PUT-Motorsport/PUTM_EV_PDMv2_2024/hardware/hardware/FTSH-107-01-L-DV-K-A/FTSH-107-01-L-DV-K-A.stp

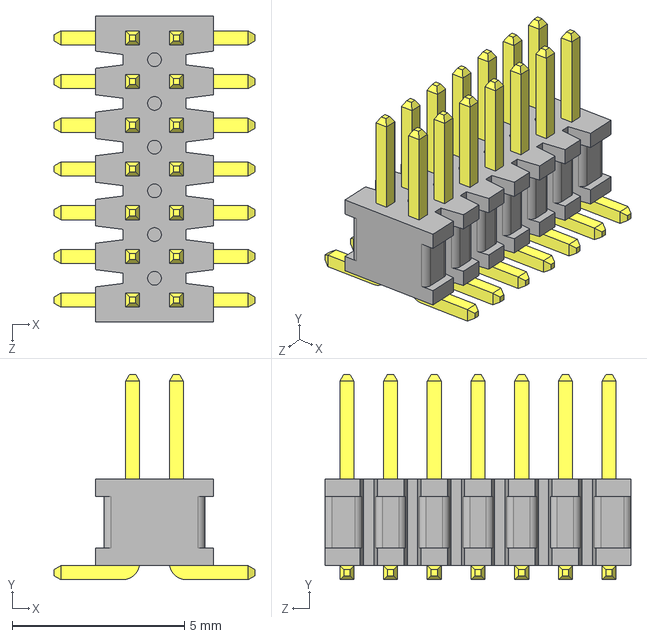
[picture p1: CAD file, 2024-11-11]
hardware/hardware/FTSH-107-01-L-DV-K-A/FTSH-107-01-L-DV-K-A.stp
5.84 x 5.97 x 8.89 mm
