PUT-Motorsport/PUTM_EV_PDMv2_2024/hardware/hardware/SKL34/SKL34.stp

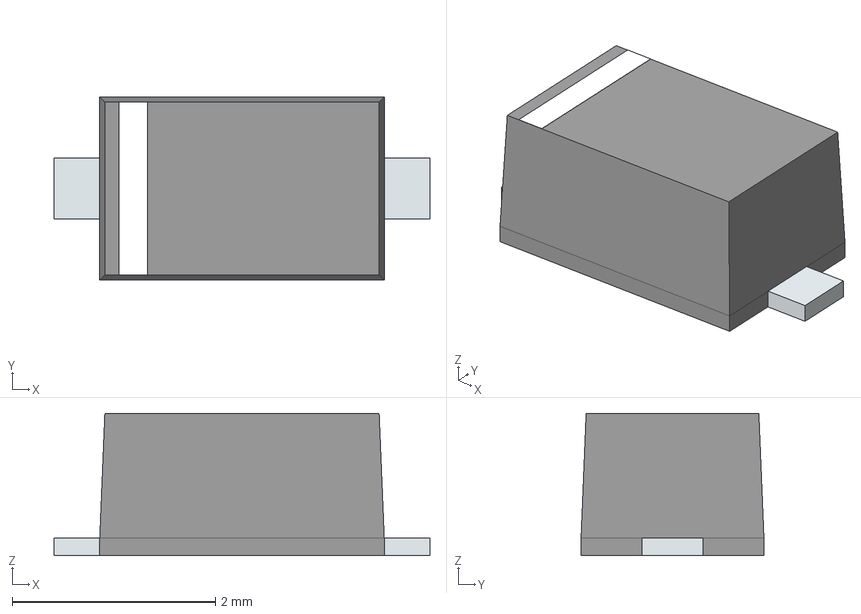
[picture p2: CAD file, 2024-12-08]
hardware/hardware/SKL34/SKL34.stp
3.70 x 1.80 x 1.40 mm
PinKIdent
PinK
PinA
