PUT-Motorsport/PUTM_EV_PDMv2_2024/hardware/hardware/UMPT-08-01-L-RA-WT-P-TR/UMPT-08-01-L-RA-WT-P-TR--3DModel-STEP-418109.STEP

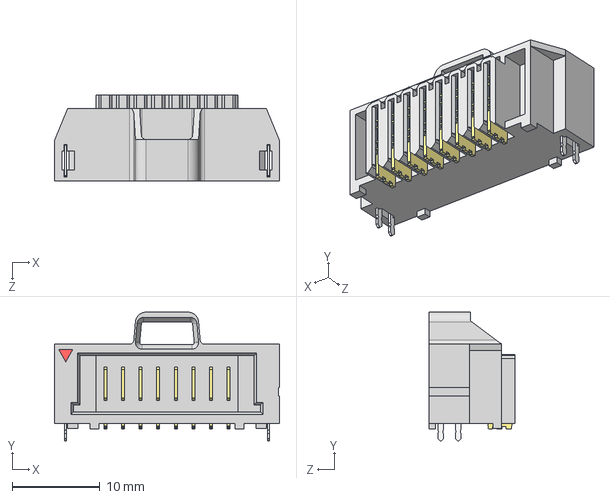
[picture p3: CAD file, 2024-12-08]
hardware/hardware/UMPT-08-01-L-RA-WT-P-TR/UMPT-08-01-L-RA-WT-P-TR--3DModel-STEP-418109.STEP
25.6 x 14.6 x 9.75 mm
