PUT-Motorsport/PUTM_EV_PDMv2_2024/hardware/hardware/UPT-02-01-01-L-RA/UPT-02-01-01-X-RA.step

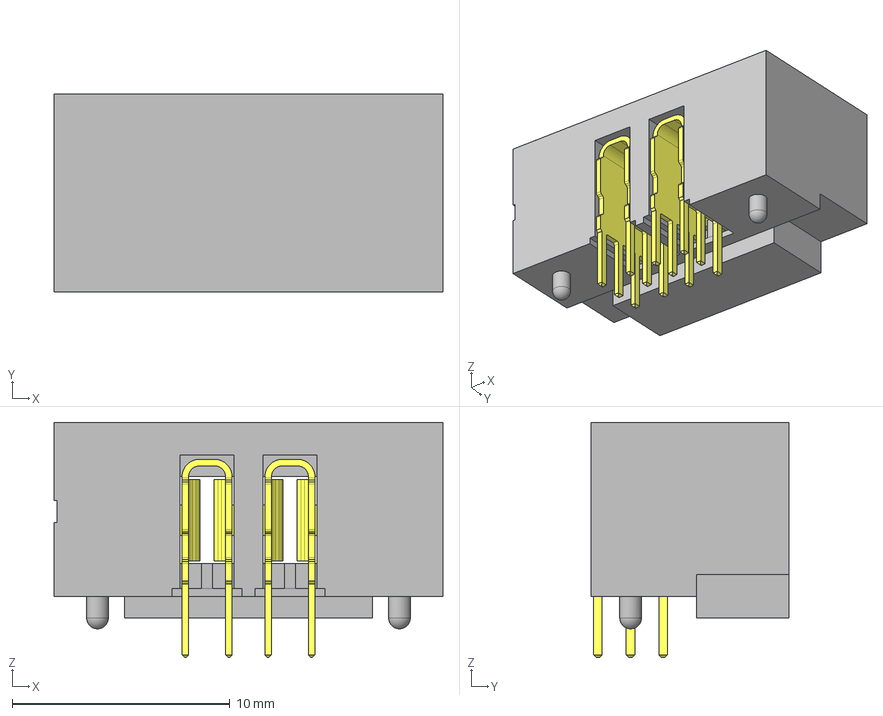
[picture p4: CAD file, 2024-11-05]
hardware/hardware/UPT-02-01-01-L-RA/UPT-02-01-01-X-RA.step
17.9 x 9.12 x 10.8 mm
UPT-03.0-0201-L-RAterminal
UPT-03.0-0201-L-RApins
