PUT-Motorsport/PUTM_EV_PDMv2_2024/hardware/hardware/UPT-08-01.0-01-L-RA/UPT-08-01-01-L-RA.stp

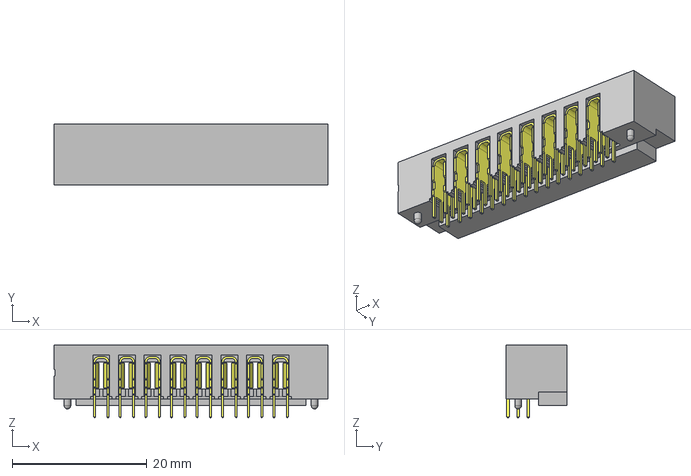
[picture p5: CAD file, 2024-11-05]
hardware/hardware/UPT-08-01.0-01-L-RA/UPT-08-01-01-L-RA.stp
40.7 x 9.12 x 10.8 mm
UPT-03.0-0801-L-RAterminal
UPT-03.0-0801-L-RApins
