PUT-Motorsport/PUTM_EV_PDMv2_2024/hardware/hardware/BTS722204ESAXUMA1/KiCad/BTS722204ESAXUMA1.stp

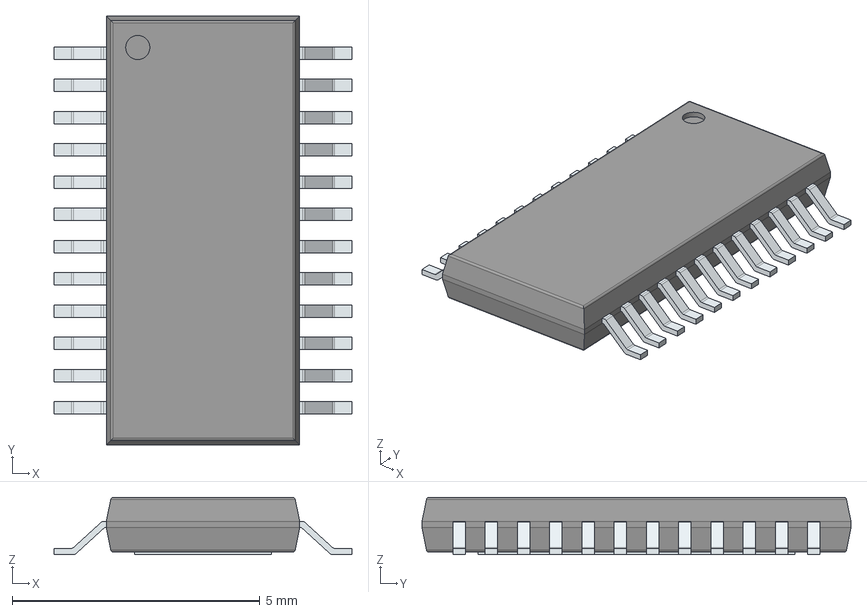
[picture p6: CAD file, 2024-11-11]
hardware/hardware/BTS722204ESAXUMA1/KiCad/BTS722204ESAXUMA1.stp
6.00 x 8.65 x 1.15 mm
PinsArrayLR
ThermalPad
