PUT-Motorsport/PUTM_EV_PDMv2_2024/hardware/hardware/inductor6_3/7447786147.stp

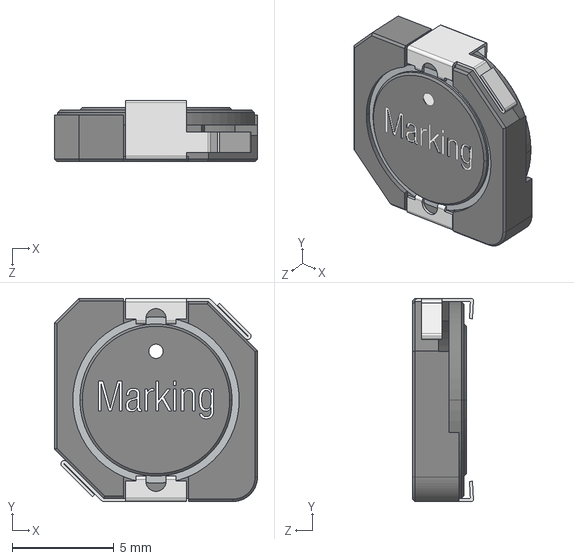
[picture p7: CAD file, 2024-11-11]
hardware/hardware/inductor6_3/7447786147.stp
10.0 x 10.0 x 3.00 mm
