PUT-Motorsport/PUTM_EV_PDMv2_2024/hardware/hardware/Redcube conn/74650073R.stp

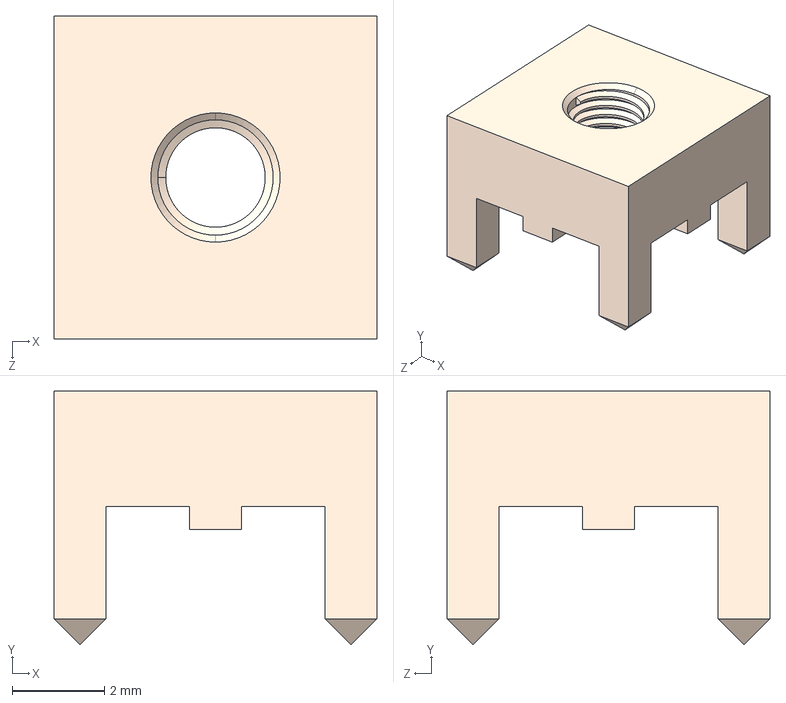
[picture p8: CAD file, 2024-12-08]
hardware/hardware/Redcube conn/74650073R.stp
7.00 x 5.50 x 7.00 mm
