PUT-Motorsport/PUTM_EV_PDMv2_2024/hardware/hardware/RedCube/7464100.stp

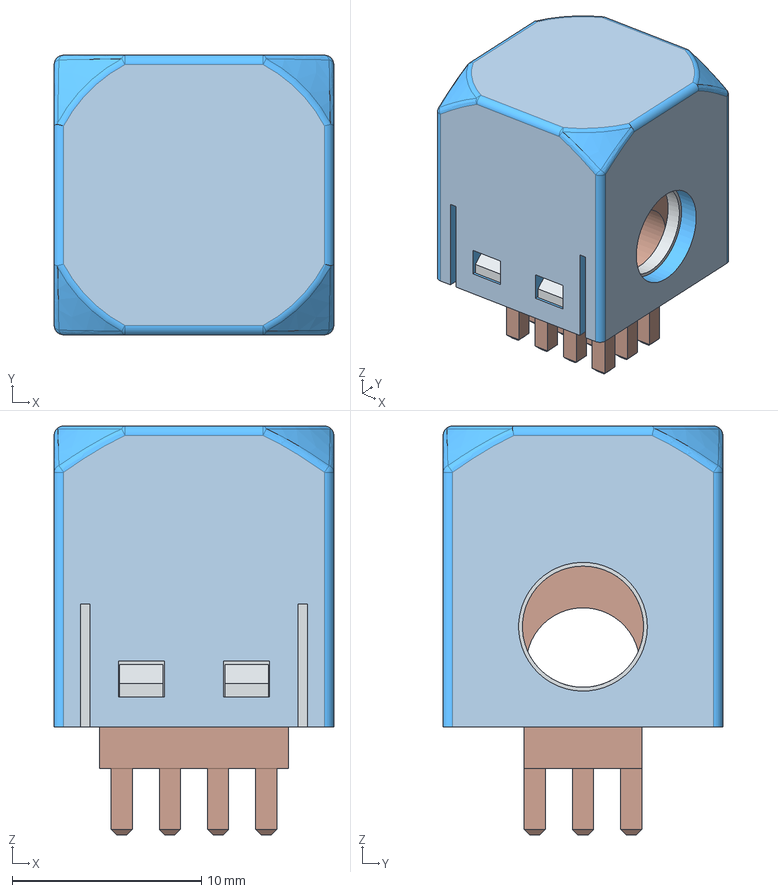
[picture p9: CAD file, 2024-12-08]
hardware/hardware/RedCube/7464100.stp
14.8 x 14.8 x 21.6 mm
Bottom Part
Top Part
pressure spring
