PUT-Motorsport/PUTM_EV_PDMv2_2024/hardware/PUTM_EV_PDMv2_2024.kicad_pcb

## KiCad design hardware/PUTM_EV_PDMv2_2024.kicad_pcb (2025-03-18)

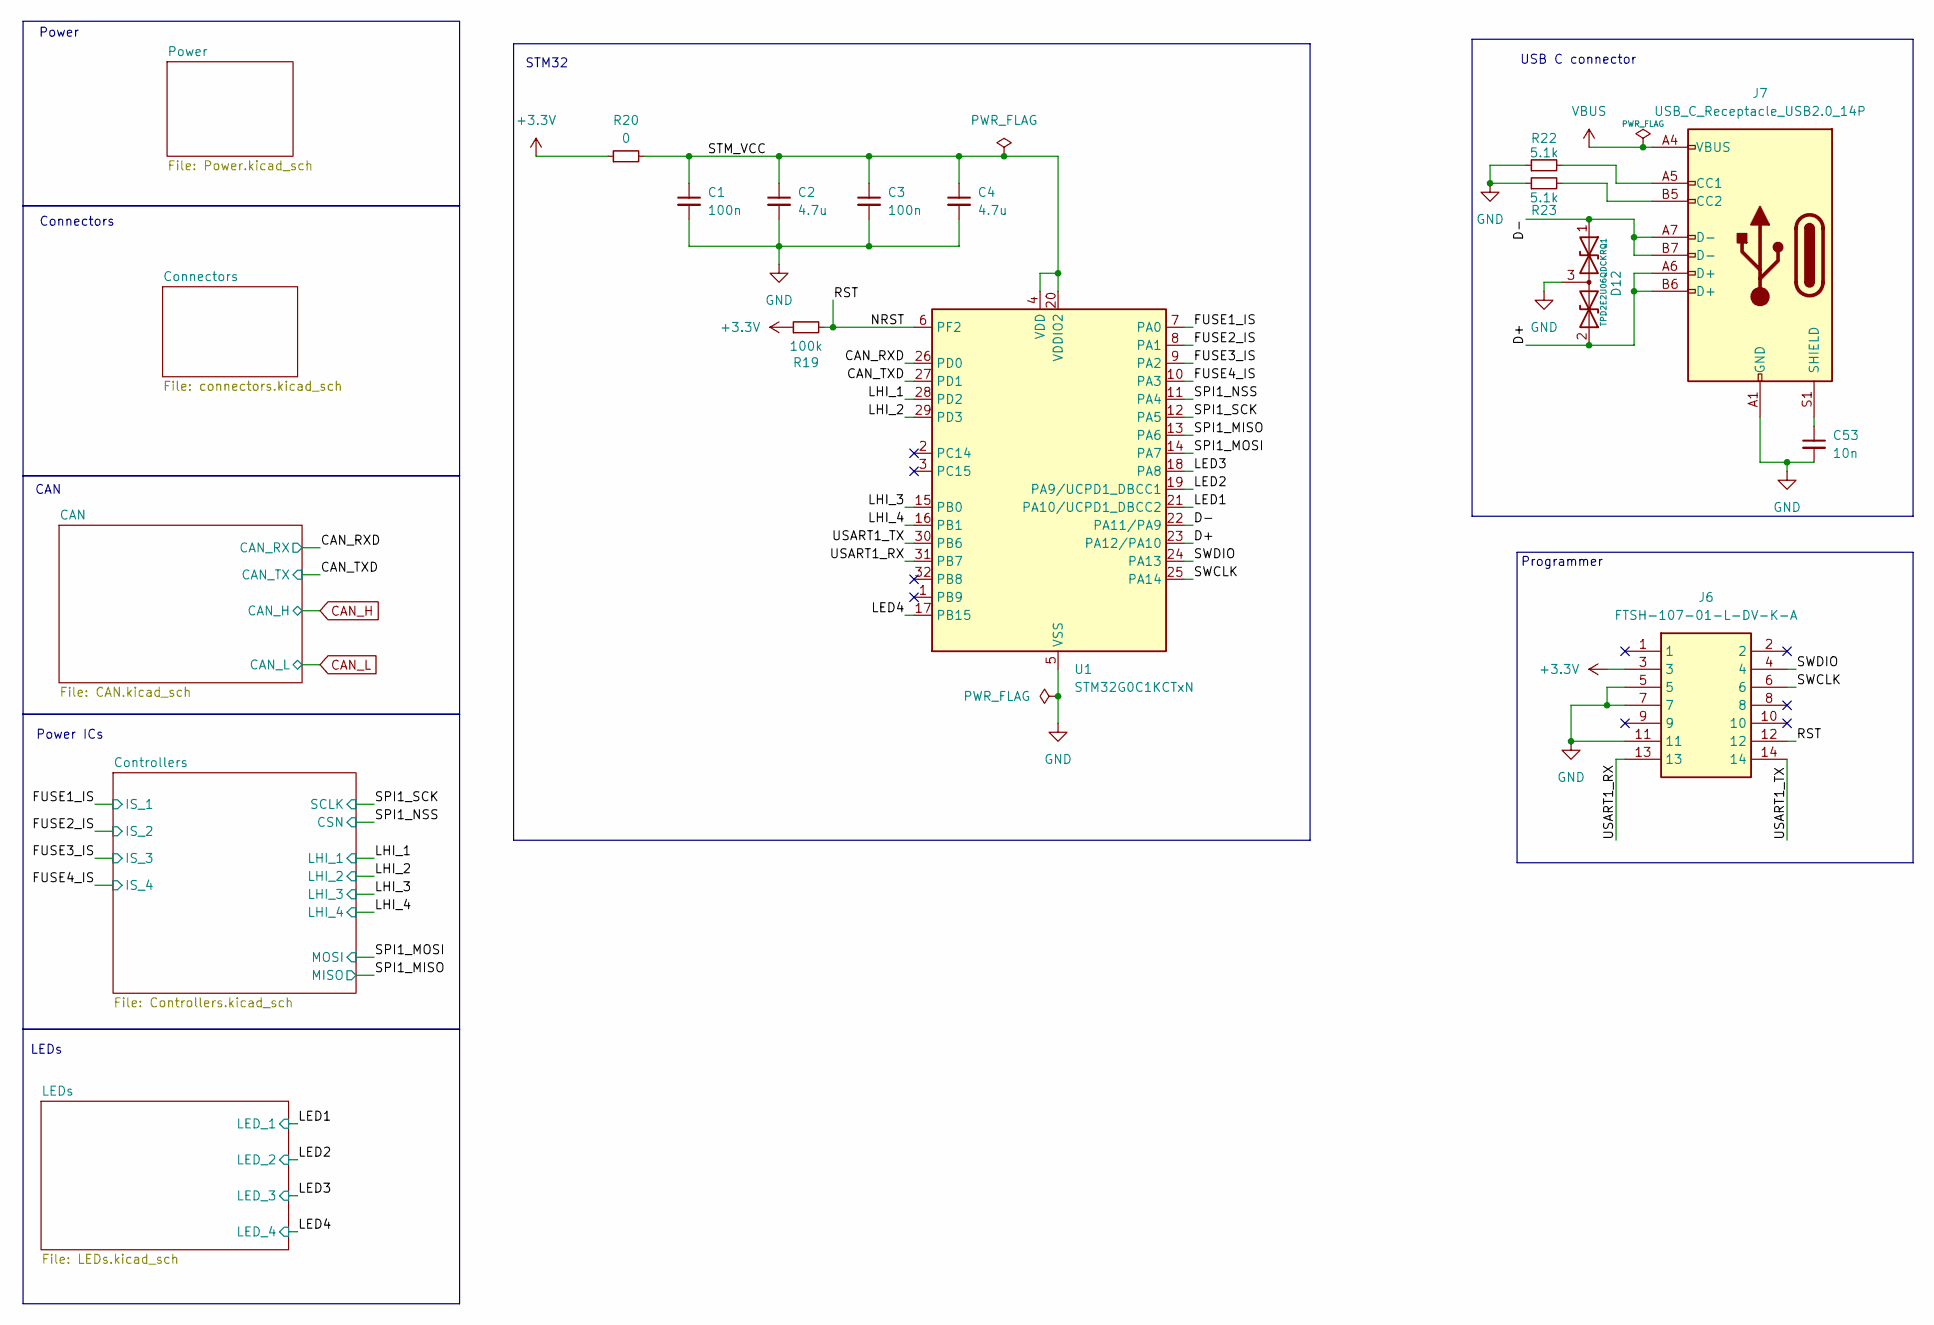
[picture p10: schematic PUTM_EV_PDMv2_2024.kicad_sch]

Parts:
C1, C3: 100n; C_0603_1608Metric
C2, C4: 4.7u; C_0603_1608Metric
C53: 10n; C_0603_1608Metric_Pad1.08x0.95mm_HandSolder
D12: TPD2E2U06QDCKRQ1; SOT-323_SC-70_Handsoldering
J6: FTSH-107-01-L-DV-K-A; FTSH-107-XX-YYY-DV-K-A; Mouser Part Number 200-FTSH10701LDVKA
J7: USB_C_Receptacle_USB2.0_14P; USB_C_Receptacle_JAE_DX07S024WJ3R400
R19: 100k; R_0603_1608Metric
R20: 0; R_0603_1608Metric_Pad0.98x0.95mm_HandSolder
R22, R23: 5.1k; R_0603_1608Metric_Pad0.98x0.95mm_HandSolder
U1: STM32G0C1KCTxN; LQFP-32_7x7mm_P0.8mm

Connections:
+3.3V: J6.3, R19.1, R20.1; also elsewhere on the board
/CAN_RXD: U1.26 (PD0); also elsewhere on the board
/CAN_TXD: U1.27 (PD1); also elsewhere on the board
/D+: D12.2 (A2), J7.A6 (D+), J7.B6 (D+), U1.23 (PA12/PA10)
/D-: D12.1 (A1), J7.A7 (D-), J7.B7 (D-), U1.22 (PA11/PA9)
/FUSE1_IS: U1.7 (PA0); also elsewhere on the board
/FUSE2_IS: U1.8 (PA1); also elsewhere on the board
/FUSE3_IS: U1.9 (PA2); also elsewhere on the board
/FUSE4_IS: U1.10 (PA3); also elsewhere on the board
/LED1: U1.21 (PA10/UCPD1_DBCC2); also elsewhere on the board
/LED2: U1.19 (PA9/UCPD1_DBCC1); also elsewhere on the board
/LED3: U1.18 (PA8); also elsewhere on the board
/LED4: U1.17 (PB15); also elsewhere on the board
/LHI_1: U1.28 (PD2); also elsewhere on the board
/LHI_2: U1.29 (PD3); also elsewhere on the board
/LHI_3: U1.15 (PB0); also elsewhere on the board
/LHI_4: U1.16 (PB1); also elsewhere on the board
/NRST: J6.12, R19.2, U1.6 (PF2)
/SPI1_MISO: U1.13 (PA6); also elsewhere on the board
/SPI1_MOSI: U1.14 (PA7); also elsewhere on the board
/SPI1_NSS: U1.11 (PA4); also elsewhere on the board
/SPI1_SCK: U1.12 (PA5); also elsewhere on the board
/STM_VCC: C1.1, C2.1, C3.1, C4.1, R20.2, U1.4 (VDD), U1.20 (VDDIO2)
/SWCLK: J6.6, U1.25 (PA14)
/SWDIO: J6.4, U1.24 (PA13)
/USART1_RX: J6.13, U1.31 (PB7)
/USART1_TX: J6.14, U1.30 (PB6)
GND: C1.2, C2.2, C3.2, C4.2, C53.2, D12.3 (common), J6.5, J6.7, J6.11, J7.A1 (GND), J7.A12 (GND), J7.B1 (GND), J7.B12 (GND), R22.1, R23.1, U1.5 (VSS); also elsewhere on the board
unnamed: J7.A5 (CC1), R22.2
unnamed: J7.B5 (CC2), R23.2
unnamed: C53.1, J7.S1 (SHIELD)
VBUS: J7.A4 (VBUS), J7.A9 (VBUS), J7.B4 (VBUS), J7.B9 (VBUS); also elsewhere on the board

Notes on the sheet:
Connectors
CAN
Programmer
LEDs
STM32
USB C connector
Power
Power ICs

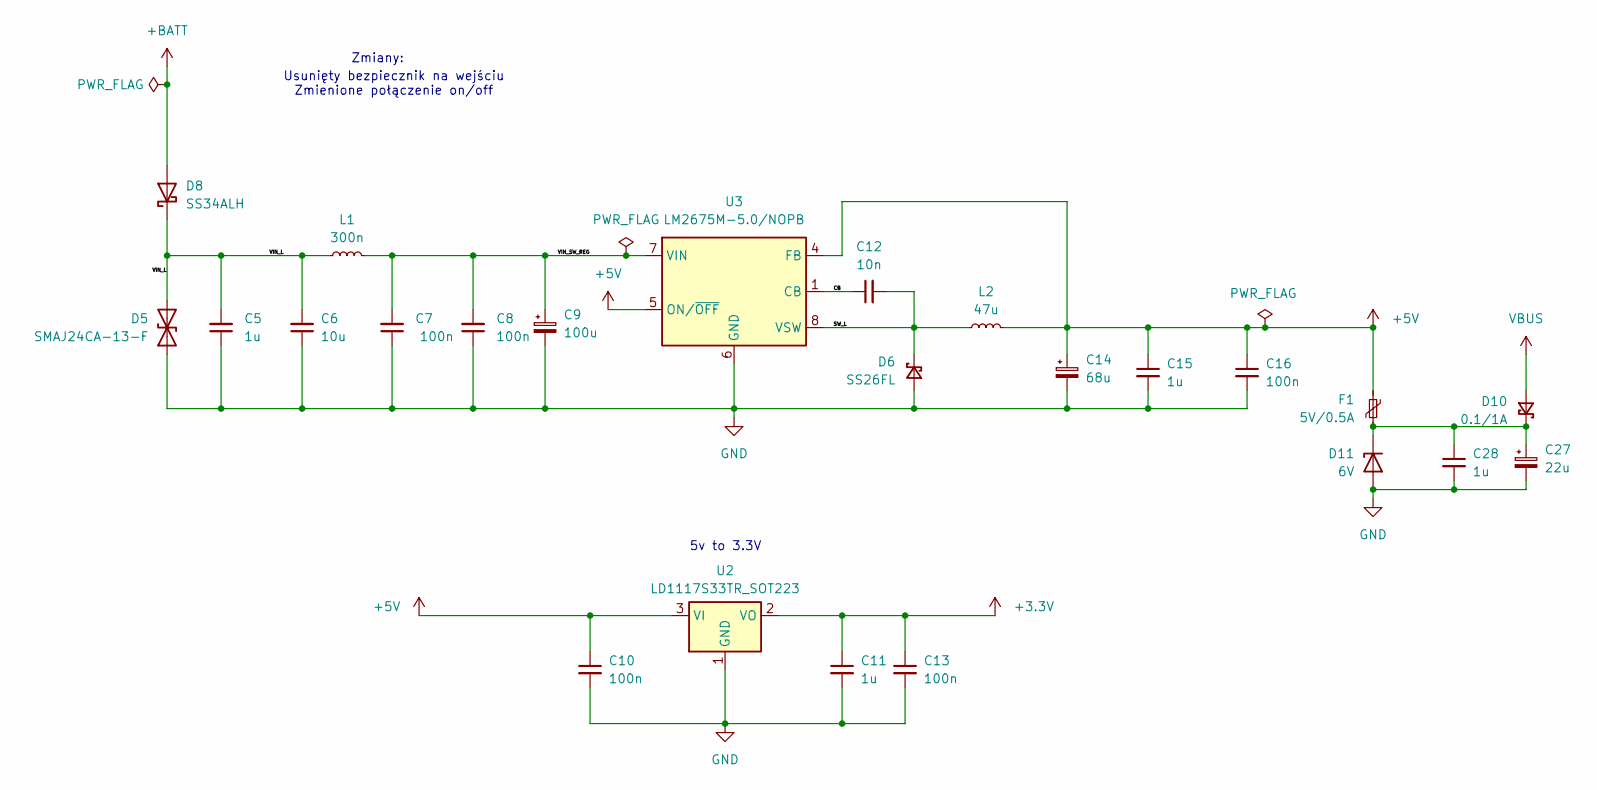
[picture p11: schematic Power.kicad_sch]

Parts:
C5, C11, C15: 1u; C_0603_1608Metric
C6: 10u; C_0603_1608Metric
C7, C8, C10, C13, C16: 100n; C_0603_1608Metric
C9: 100u; CP_Elec_6.3x7.7
C12: 10n; C_0603_1608Metric
C14: 68u; CP_Elec_6.3x5.4
C27: 22u; CP_Elec_4x4.5
C28: 1u; C_0603_1608Metric_Pad1.08x0.95mm_HandSolder
D5: SMAJ24CA-13-F; D_SMA; Mouser Part Number 621-SMAJ24CA-13-F
D6: SS26FL; D_SOD-123
D8: SS34ALH; D_SMA
D10: 0.1/1A; D_SMA
D11: 6V; D_SOD-123
F1: 5V/0.5A; Fuse_1206_3216Metric_Pad1.42x1.75mm_HandSolder
L1: 300n; L_0603_1608Metric
L2: 47u; L_6.3x6.3_H3
U2: LD1117S33TR_SOT223; SOT-223-3_TabPin2
U3: LM2675M-5.0/NOPB; SOIC-8_3.9x4.9mm_P1.27mm

Connections:
+3.3V: C11.1, C13.1, U2.2 (VO); also elsewhere on the board
+5V: C10.1, C14.1, C15.1, C16.1, F1.1, L2.2, U2.3 (VI), U3.4 (FB), U3.5 (ON/~OFF); also elsewhere on the board
+BATT: D8.2 (A); also elsewhere on the board
/Power/CB: C12.1, U3.1 (CB)
/Power/SW_L: C12.2, D6.1 (K), L2.1, U3.8 (VSW)
/Power/VIN_L: C5.2, C6.2, D5.2 (A2), D8.1 (K), L1.1
/Power/VIN_SW_REG: C7.2, C8.2, C9.1, L1.2, U3.7 (VIN)
GND: C5.1, C6.1, C7.1, C8.1, C9.2, C10.2, C11.2, C13.2, C14.2, C15.2, C16.2, C27.2, C28.2, D5.1 (A1), D6.2 (A), D11.2 (A), U2.1 (GND), U3.6 (GND); also elsewhere on the board
unnamed: C27.1, C28.1, D10.1 (K), D11.1 (K), F1.2
VBUS: D10.2 (A); also elsewhere on the board

Notes on the sheet:
Zmiany:
Usunięty bezpiecznik na wejściu Zmienione połączenie on/off
5v to 3.3V

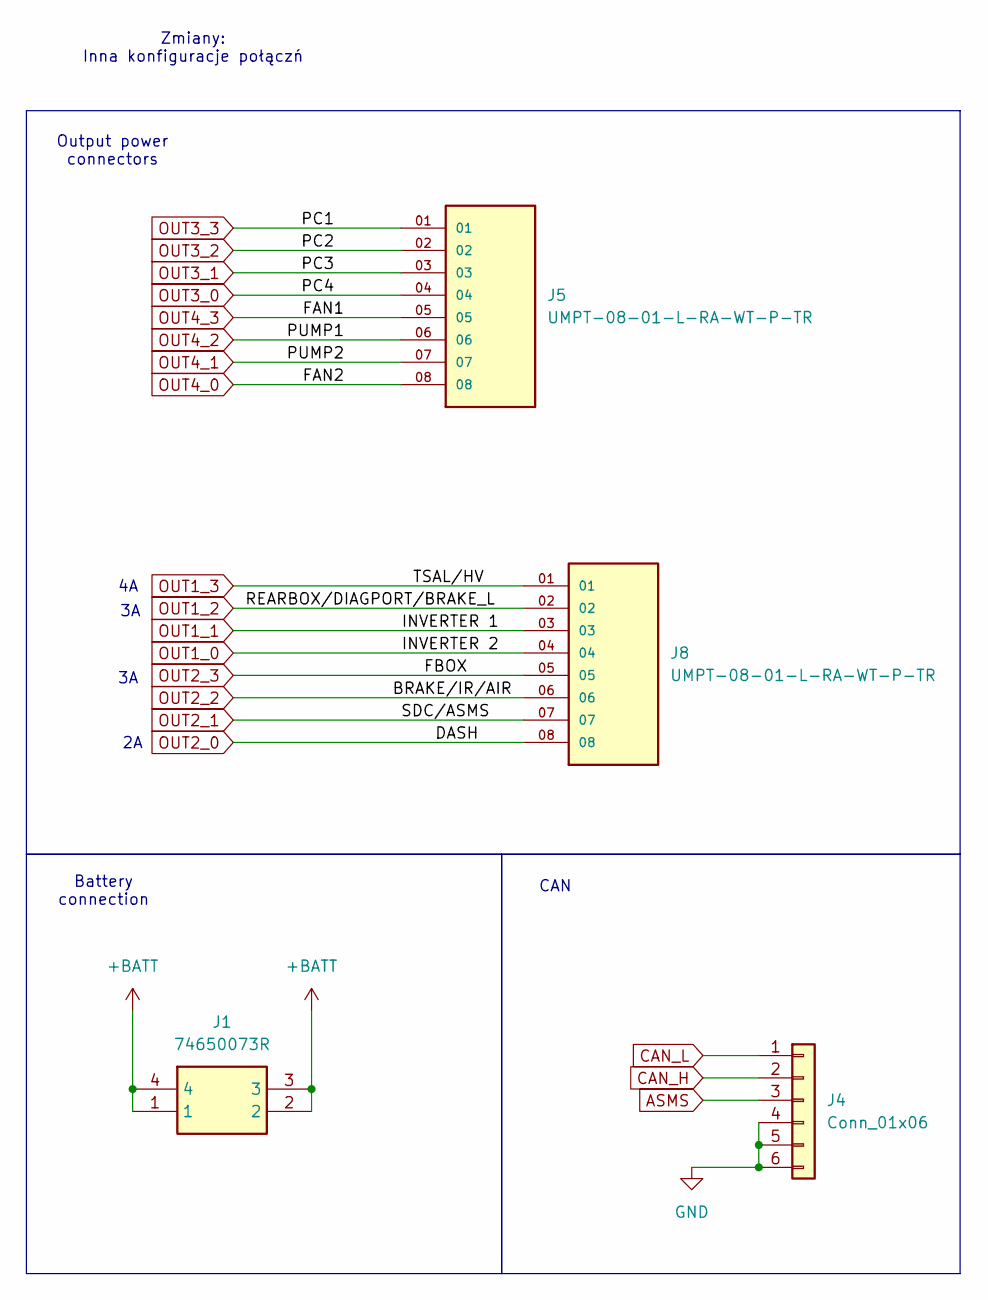
[picture p12: schematic connectors.kicad_sch]

Parts:
J1: 74650073R; Mouser Part Number 710-74650073R
J4: Conn_01x06; IDC-Header_2x03_P2.54mm_Vertical
J5, J8: UMPT-08-01-L-RA-WT-P-TR; SAMTEC_UMPT-08-01-L-RA-WT-P-TR

Connections:
+BATT: J1.1, J1.2, J1.3, J1.4; also elsewhere on the board
ASMS: J4.3
CAN_H: J4.2; also elsewhere on the board
CAN_L: J4.1; also elsewhere on the board
GND: J4.4, J4.5, J4.6; also elsewhere on the board
OUT1_0: J8.04; also elsewhere on the board
OUT1_1: J8.03; also elsewhere on the board
OUT1_2: J8.02; also elsewhere on the board
OUT1_3: J8.01; also elsewhere on the board
OUT2_0: J8.08; also elsewhere on the board
OUT2_1: J8.07; also elsewhere on the board
OUT2_2: J8.06; also elsewhere on the board
OUT2_3: J8.05; also elsewhere on the board
OUT3_0: J5.04; also elsewhere on the board
OUT3_1: J5.03; also elsewhere on the board
OUT3_2: J5.02; also elsewhere on the board
OUT3_3: J5.01; also elsewhere on the board
OUT4_0: J5.08; also elsewhere on the board
OUT4_1: J5.07; also elsewhere on the board
OUT4_2: J5.06; also elsewhere on the board
OUT4_3: J5.05; also elsewhere on the board

Notes on the sheet:
CAN
Battery connection
Output power connectors
Zmiany: Inna konfiguracje połączń

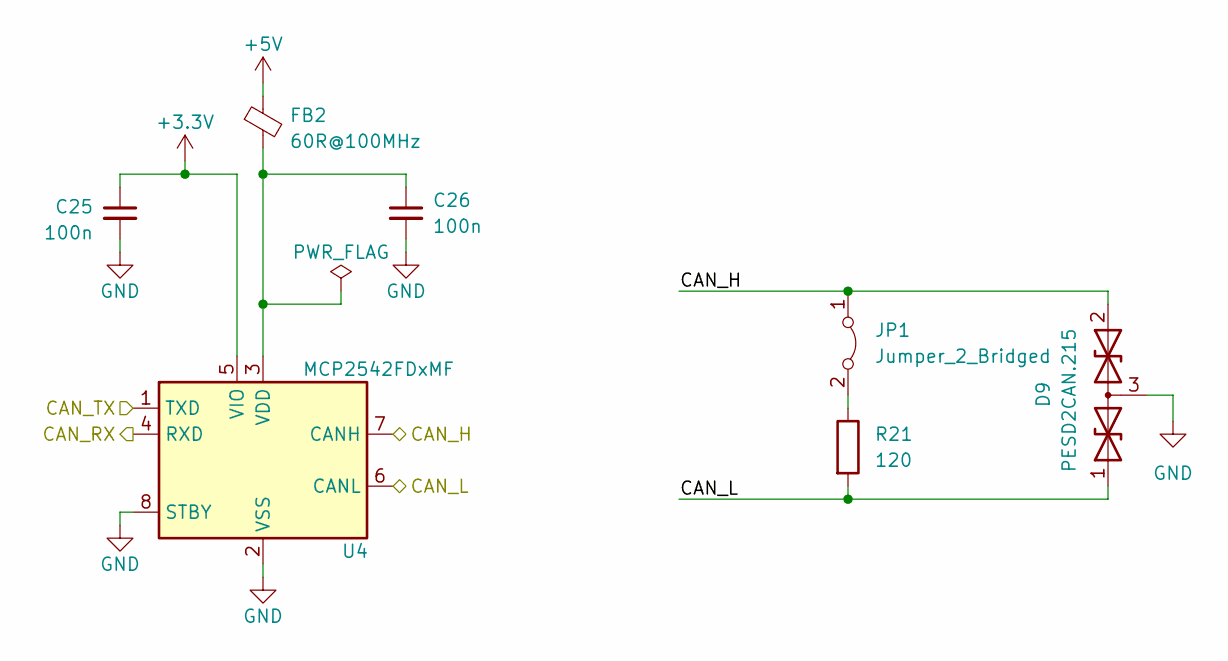
[picture p13: schematic CAN.kicad_sch]

Parts:
C25, C26: 100n; C_0603_1608Metric_Pad1.08x0.95mm_HandSolder
D9: PESD2CAN.215; SOT-23
FB2: 60R@100MHz; L_0603_1608Metric
JP1: Jumper_2_Bridged; PinHeader_1x02_P2.54mm_Vertical
R21: 120; R_0603_1608Metric_Pad0.98x0.95mm_HandSolder
U4: MCP2542FDxMF; DFN-8-1EP_3x3mm_P0.65mm_EP1.55x2.4mm

Connections:
+3.3V: C25.1, U4.5 (VIO); also elsewhere on the board
+5V: FB2.1; also elsewhere on the board
/CAN_RXD: U4.4 (RXD); also elsewhere on the board
/CAN_TXD: U4.1 (TXD); also elsewhere on the board
CAN_H: D9.2 (A2), JP1.1 (A), U4.7 (CANH); also elsewhere on the board
CAN_L: D9.1 (A1), R21.2, U4.6 (CANL); also elsewhere on the board
GND: C25.2, C26.2, D9.3 (common), U4.2 (VSS), U4.8 (STBY), U4.9 (VSS); also elsewhere on the board
unnamed: JP1.2 (B), R21.1
unnamed: C26.1, FB2.2, U4.3 (VDD)

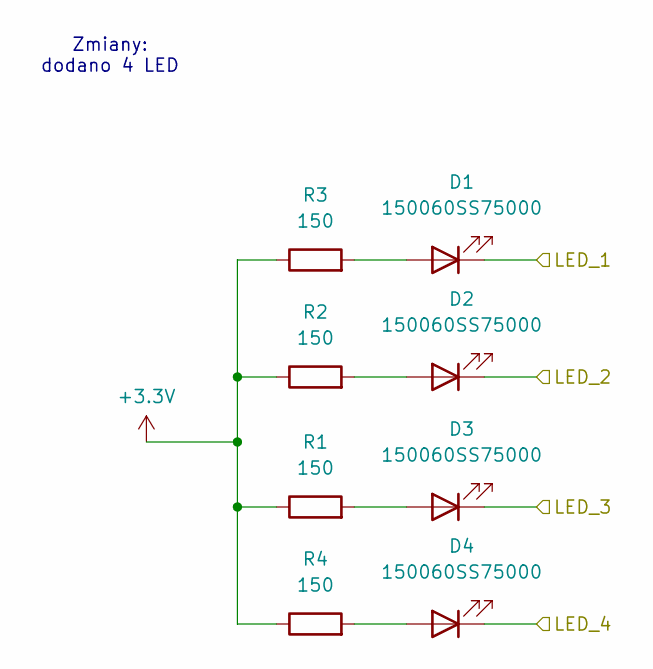
[picture p14: schematic LEDs.kicad_sch]

Parts:
D1, D2, D3, D4: 150060SS75000; LED_0603_1608Metric
R1, R2, R3, R4: 150; R_0603_1608Metric_Pad0.98x0.95mm_HandSolder

Connections:
+3.3V: R1.1, R2.1, R3.1, R4.1; also elsewhere on the board
/LED1: D1.1 (K); also elsewhere on the board
/LED2: D2.1 (K); also elsewhere on the board
/LED3: D3.1 (K); also elsewhere on the board
/LED4: D4.1 (K); also elsewhere on the board
unnamed: D1.2 (A), R3.2
unnamed: D2.2 (A), R2.2
unnamed: D3.2 (A), R1.2
unnamed: D4.2 (A), R4.2

Notes on the sheet:
Zmiany: dodano 4 LED

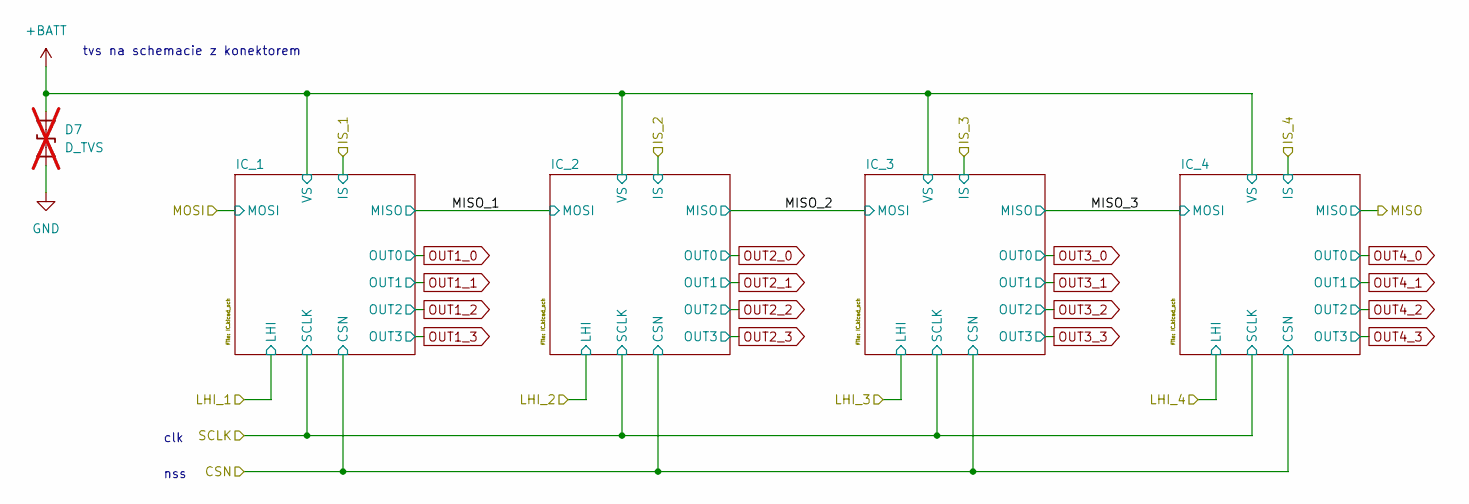
[picture p15: schematic Controllers.kicad_sch]

Parts:
D7: D_TVS; not fitted

Notes on the sheet:
nss
clk
tvs na schemacie z konektorem

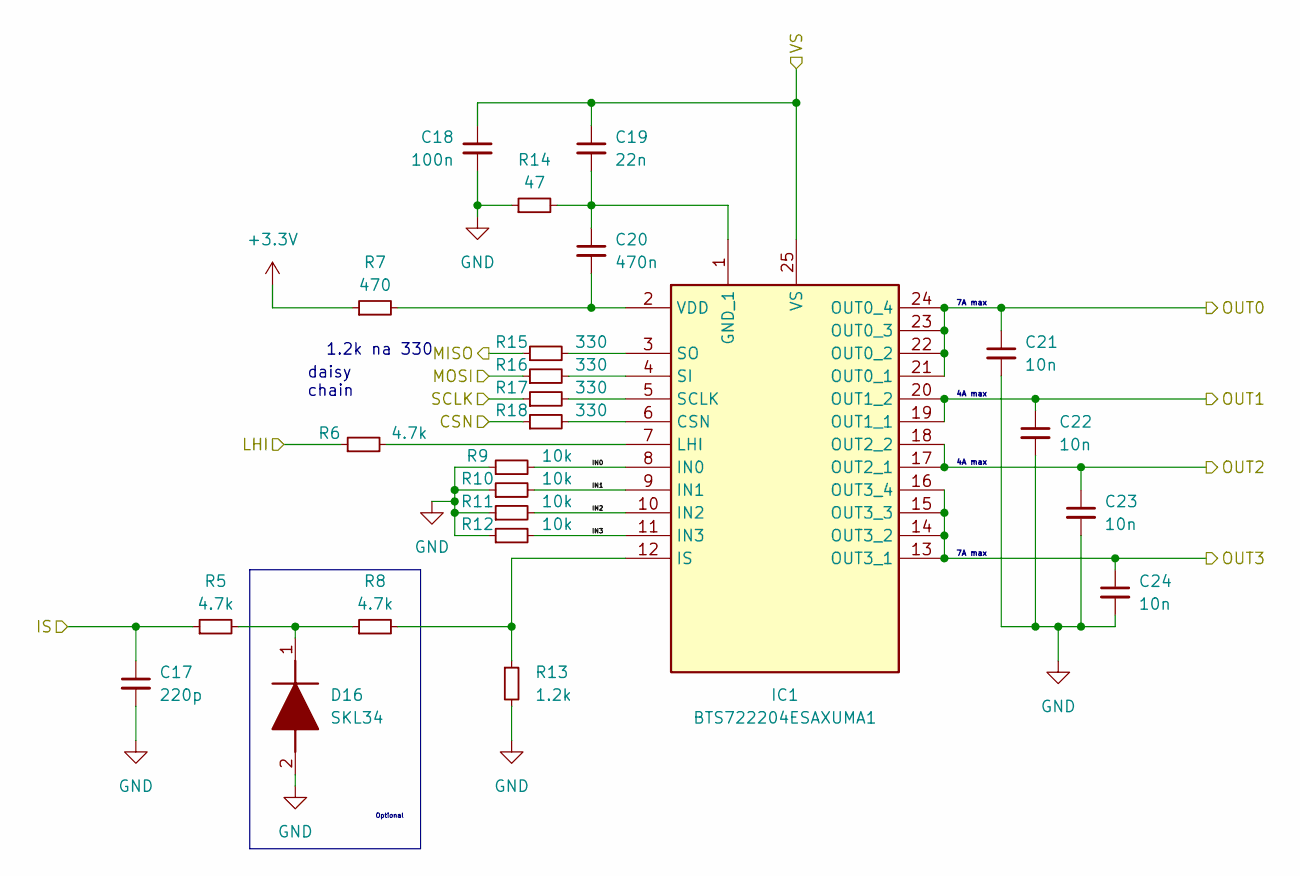
[picture p16: schematic IC.kicad_sch]

Parts:
C17: 220p; C_0603_1608Metric_Pad1.08x0.95mm_HandSolder
C18: 100n; C_0603_1608Metric_Pad1.08x0.95mm_HandSolder
C19: 22n; C_0603_1608Metric_Pad1.08x0.95mm_HandSolder
C20: 470n; C_0603_1608Metric_Pad1.08x0.95mm_HandSolder
C21, C22, C23, C24: 10n; C_0805_2012Metric
D16: SKL34; SODFL3718X140N; Mouser Part Number 637-SKL34
IC1: BTS722204ESAXUMA1; SOP65P600X115-25N; Mouser Part Number 726-BTS722204ESAXUMA
R5, R6, R8: 4.7k; R_0603_1608Metric_Pad0.98x0.95mm_HandSolder
R7: 470; R_0603_1608Metric_Pad0.98x0.95mm_HandSolder
R9, R10, R11, R12: 10k; R_0603_1608Metric_Pad0.98x0.95mm_HandSolder
R13: 1.2k; R_0603_1608Metric_Pad0.98x0.95mm_HandSolder
R14: 47; R_0603_1608Metric_Pad0.98x0.95mm_HandSolder
R15, R16, R17, R18: 330; R_0603_1608Metric_Pad0.98x0.95mm_HandSolder

Connections:
+3.3V: R7.1; also elsewhere on the board
+BATT: C18.1, C19.1, IC1.25 (VS); also elsewhere on the board
/Controllers/IC_1/IN0: IC1.8 (IN0), R9.2
/Controllers/IC_1/IN1: IC1.9 (IN1), R10.2
/Controllers/IC_1/IN2: IC1.10 (IN2), R11.2
/Controllers/IC_1/IN3: IC1.11 (IN3), R12.2
/Controllers/MISO_1: R15.1; also elsewhere on the board
/FUSE1_IS: C17.1, R5.1; also elsewhere on the board
/LHI_1: R6.1; also elsewhere on the board
/SPI1_MOSI: R16.1; also elsewhere on the board
/SPI1_NSS: R18.1; also elsewhere on the board
/SPI1_SCK: R17.1; also elsewhere on the board
GND: C17.2, C18.2, C21.2, C22.2, C23.2, C24.2, D16.2 (A), R9.1, R10.1, R11.1, R12.1, R13.2, R14.1; also elsewhere on the board
unnamed: D16.1 (K), R5.2, R8.1
unnamed: IC1.6 (CSN), R18.2
unnamed: C19.2, C20.1, IC1.1 (GND_1), R14.2
unnamed: IC1.12 (IS), R8.2, R13.1
unnamed: IC1.7 (LHI), R6.2
unnamed: IC1.5 (SCLK), R17.2
unnamed: IC1.4 (SI), R16.2
unnamed: IC1.3 (SO), R15.2
unnamed: C20.2, IC1.2 (VDD), R7.2
OUT1_0: C21.1, IC1.21 (OUT0_1), IC1.22 (OUT0_2), IC1.23 (OUT0_3), IC1.24 (OUT0_4); also elsewhere on the board
OUT1_1: C22.1, IC1.19 (OUT1_1), IC1.20 (OUT1_2); also elsewhere on the board
OUT1_2: C23.1, IC1.17 (OUT2_1), IC1.18 (OUT2_2); also elsewhere on the board
OUT1_3: C24.1, IC1.13 (OUT3_1), IC1.14 (OUT3_2), IC1.15 (OUT3_3), IC1.16 (OUT3_4); also elsewhere on the board

Parts of its further copies:
C29, C37, C45: 220p; C_0603_1608Metric_Pad1.08x0.95mm_HandSolder
C30, C38, C46: 100n; C_0603_1608Metric_Pad1.08x0.95mm_HandSolder
C31, C39, C47: 22n; C_0603_1608Metric_Pad1.08x0.95mm_HandSolder
C32, C40, C48: 470n; C_0603_1608Metric_Pad1.08x0.95mm_HandSolder
C33, C34, C35, C36, C41, C42, C43, C44, C49, C50, C51, C52: 10n; C_0805_2012Metric
D17, D18, D19: SKL34; SODFL3718X140N; Mouser Part Number 637-SKL34
IC2, IC3, IC4: BTS722204ESAXUMA1; SOP65P600X115-25N; Mouser Part Number 726-BTS722204ESAXUMA
R24, R25, R27, R38, R39, R41, R52, R53, R55: 4.7k; R_0603_1608Metric_Pad0.98x0.95mm_HandSolder
R26, R40, R54: 470; R_0603_1608Metric_Pad0.98x0.95mm_HandSolder
R28, R29, R30, R31, R42, R43, R44, R45, R56, R57, R58, R59: 10k; R_0603_1608Metric_Pad0.98x0.95mm_HandSolder
R32, R46, R60: 1.2k; R_0603_1608Metric_Pad0.98x0.95mm_HandSolder
R33, R47, R61: 47; R_0603_1608Metric_Pad0.98x0.95mm_HandSolder
R34, R35, R36, R37, R48, R49, R50, R51, R62, R63, R64, R65: 330; R_0603_1608Metric_Pad0.98x0.95mm_HandSolder

Connections of its further copies:
+3.3V: R26.1, R40.1, R54.1; also elsewhere on the board
+BATT: C30.1, C31.1, C38.1, C39.1, C46.1, C47.1, IC2.25 (VS), IC3.25 (VS), IC4.25 (VS); also elsewhere on the board
/Controllers/IC_2/IN0: IC2.8 (IN0), R28.2
/Controllers/IC_2/IN1: IC2.9 (IN1), R29.2
/Controllers/IC_2/IN2: IC2.10 (IN2), R30.2
/Controllers/IC_2/IN3: IC2.11 (IN3), R31.2
/Controllers/IC_3/IN0: IC3.8 (IN0), R42.2
/Controllers/IC_3/IN1: IC3.9 (IN1), R43.2
/Controllers/IC_3/IN2: IC3.10 (IN2), R44.2
/Controllers/IC_3/IN3: IC3.11 (IN3), R45.2
/Controllers/IC_4/IN0: IC4.8 (IN0), R56.2
/Controllers/IC_4/IN1: IC4.9 (IN1), R57.2
/Controllers/IC_4/IN2: IC4.10 (IN2), R58.2
/Controllers/IC_4/IN3: IC4.11 (IN3), R59.2
/Controllers/MISO_1: R35.1; also elsewhere on the board
/Controllers/MISO_2: R34.1, R49.1
/Controllers/MISO_3: R48.1, R63.1
/FUSE2_IS: C29.1, R24.1; also elsewhere on the board
/FUSE3_IS: C37.1, R38.1; also elsewhere on the board
/FUSE4_IS: C45.1, R52.1; also elsewhere on the board
/LHI_2: R25.1; also elsewhere on the board
/LHI_3: R39.1; also elsewhere on the board
/LHI_4: R53.1; also elsewhere on the board
/SPI1_MISO: R62.1; also elsewhere on the board
/SPI1_NSS: R37.1, R51.1, R65.1; also elsewhere on the board
/SPI1_SCK: R36.1, R50.1, R64.1; also elsewhere on the board
GND: C29.2, C30.2, C33.2, C34.2, C35.2, C36.2, C37.2, C38.2, C41.2, C42.2, C43.2, C44.2, C45.2, C46.2, C49.2, C50.2, C51.2, C52.2, D17.2 (A), D18.2 (A), D19.2 (A), R28.1, R29.1, R30.1, R31.1, R32.2, R33.1, R42.1, R43.1, R44.1, R45.1, R46.2, R47.1, R56.1, R57.1, R58.1, R59.1, R60.2, R61.1; also elsewhere on the board
unnamed: D17.1 (K), R24.2, R27.1
unnamed: D18.1 (K), R38.2, R41.1
unnamed: D19.1 (K), R52.2, R55.1
unnamed: IC2.6 (CSN), R37.2
unnamed: C31.2, C32.1, IC2.1 (GND_1), R33.2
unnamed: IC2.12 (IS), R27.2, R32.1
unnamed: IC2.7 (LHI), R25.2
unnamed: IC2.5 (SCLK), R36.2
unnamed: IC2.4 (SI), R35.2
unnamed: IC2.3 (SO), R34.2
unnamed: C32.2, IC2.2 (VDD), R26.2
unnamed: IC3.6 (CSN), R51.2
unnamed: C39.2, C40.1, IC3.1 (GND_1), R47.2
unnamed: IC3.12 (IS), R41.2, R46.1
unnamed: IC3.7 (LHI), R39.2
unnamed: IC3.5 (SCLK), R50.2
unnamed: IC3.4 (SI), R49.2
unnamed: IC3.3 (SO), R48.2
unnamed: C40.2, IC3.2 (VDD), R40.2
unnamed: IC4.6 (CSN), R65.2
unnamed: C47.2, C48.1, IC4.1 (GND_1), R61.2
unnamed: IC4.12 (IS), R55.2, R60.1
unnamed: IC4.7 (LHI), R53.2
unnamed: IC4.5 (SCLK), R64.2
unnamed: IC4.4 (SI), R63.2
unnamed: IC4.3 (SO), R62.2
unnamed: C48.2, IC4.2 (VDD), R54.2
OUT2_0: C33.1, IC2.21 (OUT0_1), IC2.22 (OUT0_2), IC2.23 (OUT0_3), IC2.24 (OUT0_4); also elsewhere on the board
OUT2_1: C34.1, IC2.19 (OUT1_1), IC2.20 (OUT1_2); also elsewhere on the board
OUT2_2: C35.1, IC2.17 (OUT2_1), IC2.18 (OUT2_2); also elsewhere on the board
OUT2_3: C36.1, IC2.13 (OUT3_1), IC2.14 (OUT3_2), IC2.15 (OUT3_3), IC2.16 (OUT3_4); also elsewhere on the board
OUT3_0: C41.1, IC3.21 (OUT0_1), IC3.22 (OUT0_2), IC3.23 (OUT0_3), IC3.24 (OUT0_4); also elsewhere on the board
OUT3_1: C42.1, IC3.19 (OUT1_1), IC3.20 (OUT1_2); also elsewhere on the board
OUT3_2: C43.1, IC3.17 (OUT2_1), IC3.18 (OUT2_2); also elsewhere on the board
OUT3_3: C44.1, IC3.13 (OUT3_1), IC3.14 (OUT3_2), IC3.15 (OUT3_3), IC3.16 (OUT3_4); also elsewhere on the board
OUT4_0: C49.1, IC4.21 (OUT0_1), IC4.22 (OUT0_2), IC4.23 (OUT0_3), IC4.24 (OUT0_4); also elsewhere on the board
OUT4_1: C50.1, IC4.19 (OUT1_1), IC4.20 (OUT1_2); also elsewhere on the board
OUT4_2: C51.1, IC4.17 (OUT2_1), IC4.18 (OUT2_2); also elsewhere on the board
OUT4_3: C52.1, IC4.13 (OUT3_1), IC4.14 (OUT3_2), IC4.15 (OUT3_3), IC4.16 (OUT3_4); also elsewhere on the board

Notes on the sheet:
7A max
Optional
4A max
daisy chain
1.2k na 330

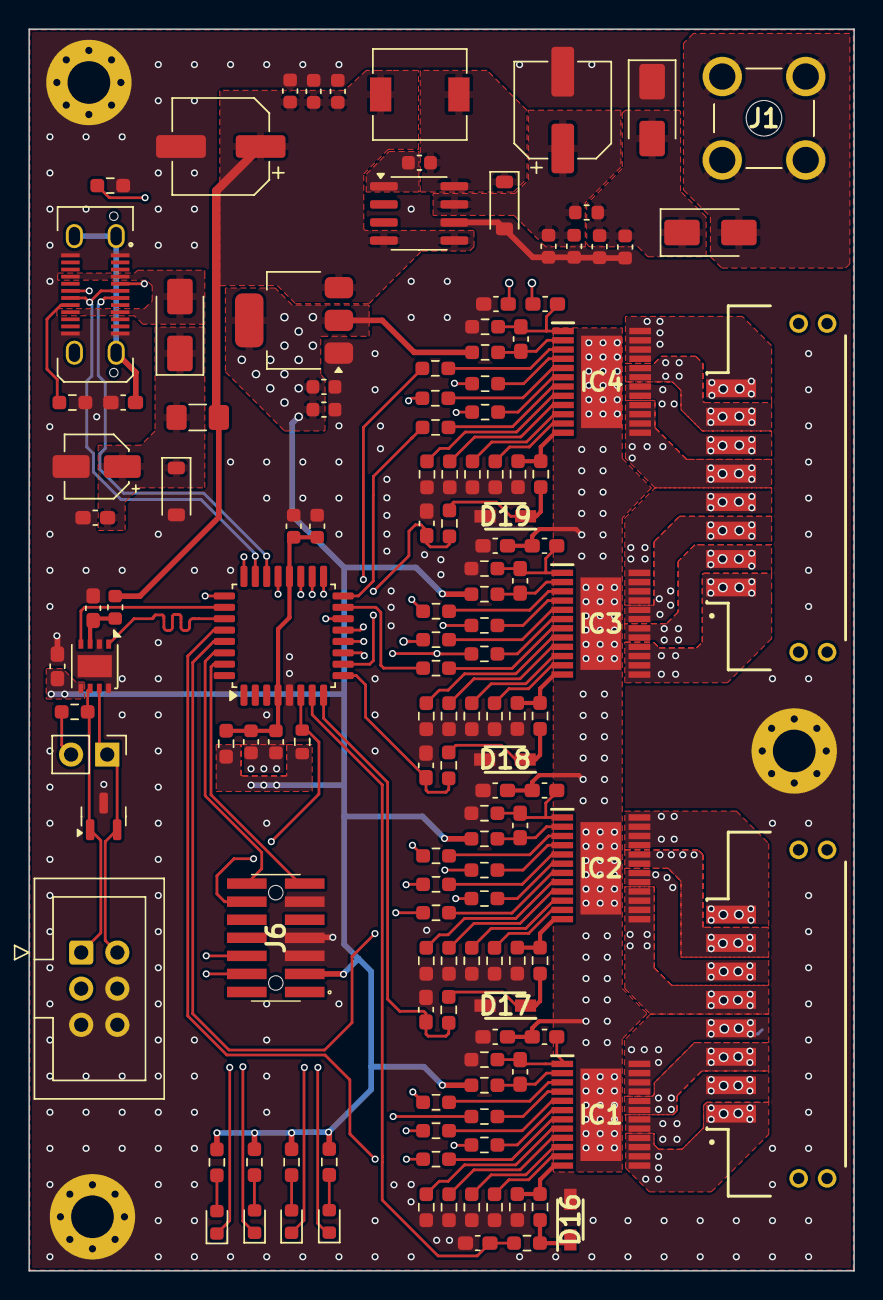
[picture p17: board PUTM_EV_PDMv2_2024.kicad_pcb from above]

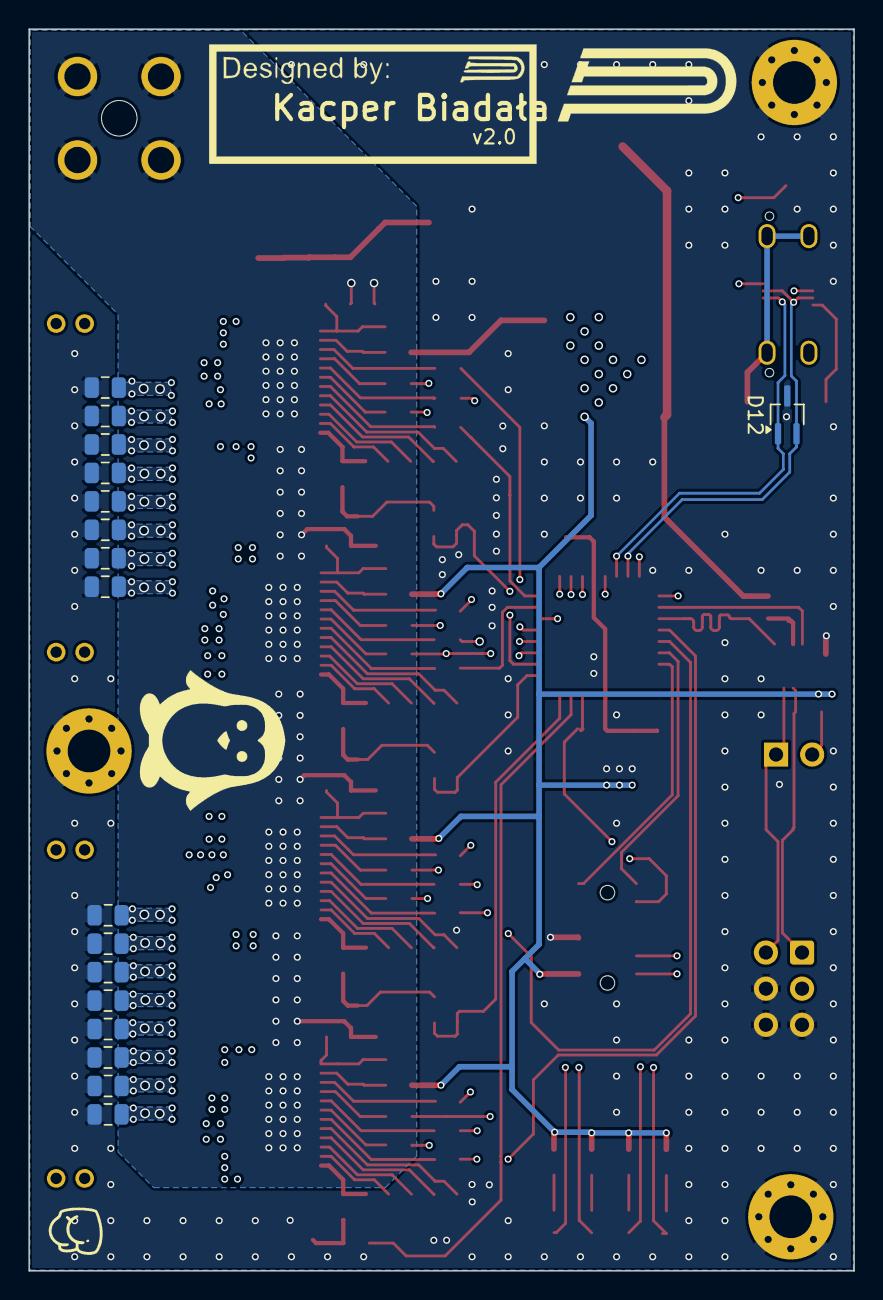
[picture p18: board PUTM_EV_PDMv2_2024.kicad_pcb from below]

Board: 4 copper layers, 58.0 x 87.3 mm, 152 parts (17 on the bottom side), 118 nets.
