PUT-Motorsport/PUTM_EV_PDMv2_2024/Software/firmware/Core/Src/main.c

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
/* Includes ------------------------------------------------------------------*/
#include "main.h"
#include "adc.h"
#include "dma.h"
#include "fdcan.h"
#include "spi.h"
#include "gpio.h"

/* USER CODE BEGIN Includes */
#include <stdbool.h>

/*
 * LED DEBUGGING SYSTEM FOR 4 BTS72220 CONTROLLERS (16 CHANNELS)
 *
 * NORMAL OPERATION:
 * - All LEDs blink at 1 Hz → System OK
 *
 * SINGLE CHANNEL FAILURE (1 ERROR ON A CONTROLLER):
 * - The LED of the faulty controller blinks in a specific pattern:
 *   - 1 blink → Channel 0 failure
 *   - 2 blinks → Channel 1 failure
 *   - 3 blinks → Channel 2 failure
 *   - 4 blinks → Channel 3 failure
 * - This pattern repeats continuously with a short pause.
 *
 * MULTIPLE CHANNEL FAILURES ON ONE CONTROLLER:
 * - The corresponding LED blinks rapidly at 5 Hz.
 *
 * MULTIPLE CONTROLLERS FAILING:
 * - Each affected controller's LED blinks rapidly at 5 Hz.
 *
 * CRITICAL FAILURE (ALL CONTROLLERS FAILING):
 * - All 4 LEDs stay solid ON.
 *
 * SYSTEM IN STANDBY/RESET:
 * - All LEDs stay OFF.
 *
 * HOW TO INTERPRET THE LEDS:
 * - Example: If LED2 blinks 3 times, pauses, then repeats → Controller 2, Channel 2 failure.
 * - Example: If LED4 blinks fast (5 Hz) → Controller 4 has multiple channel failures.
 * - Example: If all LEDs are ON → System critical failure.
 */

/* USER CODE END Includes */

/* USER CODE BEGIN PD */
#define ADC_BUF_SIZE 4
#define __VREFANALOG_VOLTAGE__ 3300
#define OUT_READY 0x8F // 1000 1111		switching to ready mode
#define OUT_READY1 0x9F // 1001 1111
#define OUT_CLOSE 0x80 // 1000 0000
#define DCR_ACTIVE 0xF5 // 1111 0101	switching to active mode
#define DCR_SLEEP 0xFF // 1111 1111
#define DCR_CHANNEL0 0xF8 // 1111 1000
#define DCR_CHANNEL1 0xF9 // 1111 1001
#define DCR_CHANNEL2 0xFA // 1111 1010
#define DCR_CHANNEL3 0xFB // 1111 1011
// Diagnosis Registers - Read Commands
#define WRNDIAG 0x01// 0000 0001
#define STDDIAG 0x02// 0000 0010
#define ERRDIAG 0x03// 0000 0011
// Configuration Registers - Read Commands
#define OUT_READ 0x00 // 0000 0000
#define RCS_READ 0x08 // 0000 1000
#define SRC_READ 0x09 // 0000 1001
#define OCR_READ 0x04 // 0000 0100
#define RCD_READ 0x0A // 0000 1100
#define KRC_READ 0x05 // 0000 0101
#define PCS_READ 0x0B // 0000 1101
#define HWCR_READ 0x05 // 0000 0110
#define ICS_READ 0x0B // 0000 1110
#define DCR_READ 0x07 // 0000 0111
//Led initialization
#define LED1_GPIO_Port GPIOA
#define LED1_Pin GPIO_PIN_10
#define LED2_GPIO_Port GPIOA
#define LED2_Pin GPIO_PIN_9
#define LED3_GPIO_Port GPIOA
#define LED3_Pin GPIO_PIN_8
#define LED4_GPIO_Port GPIOB
#define LED4_Pin GPIO_PIN_15

#define MAX_RETRIES 2

#define CLOSE_CHANNEL_0 0x8E//1000 1110
#define CLOSE_CHANNEL_1 0x8D//1000 1101
#define CLOSE_CHANNEL_2 0x8B//1000 1011
#define CLOSE_CHANNEL_3 0x87//1000 0111

/* USER CODE END PD */


/* USER CODE BEGIN PV */



uint16_t adc_buffer[ADC_BUF_SIZE];
uint8_t adc_ready = 0;

uint8_t tx_buffer[5];
uint8_t rx_buffer[5];

uint8_t after_first_loop = 0;


#define IC_COUNT 4
#define CHANNEL_COUNT 4

uint32_t fuse_currents[IC_COUNT][CHANNEL_COUNT]; // fuse_currents[ic][channel]

uint8_t channel_states[IC_COUNT] = {0x0F, 0x0F, 0x0F, 0x0F}; // All channels ON
bool any_channel_closed = false;
uint32_t last_shutdown_time = 0;

uint32_t thresholds[IC_COUNT][CHANNEL_COUNT] = {
    {200, 200, 300, 500},  // IC0 thresholds
    {200, 200, 300, 500},  // IC1
    {200, 200, 300, 500},  // IC2
    {200, 200, 300, 500}   // IC3
};
/* USER CODE END PV */

void SystemClock_Config(void);
/* USER CODE BEGIN 0 */


int get_tx_index(uint8_t ic_index)
{
    return 1 + ic_index;
}

void handle_overcurrent(uint8_t ic_index, uint8_t channel_number, uint32_t threshold)
{
    if (fuse_currents[ic_index][channel_number] > threshold && after_first_loop)
    {
    	 int tx_index = get_tx_index(ic_index);

    	        //Mark channel OFF in state
    	        channel_states[ic_index] &= ~(1 << channel_number);
    	        //track the time since the first channel is closed
    	        any_channel_closed = true;
    	        last_shutdown_time = HAL_GetTick();
    	        //Build OUT register byte from updated state
    	        for (int i = 0; i < 5; i++) tx_buffer[i] = DCR_ACTIVE;
    	        tx_buffer[tx_index] = 0x80 | (channel_states[ic_index] & 0x0F); // OUT command

    	        HAL_GPIO_WritePin(SPI1_SS_GPIO_Port, SPI1_SS_Pin, GPIO_PIN_RESET);
    	        HAL_SPI_TransmitReceive(&hspi1, tx_buffer, rx_buffer, 5, 100);
    	        HAL_GPIO_WritePin(SPI1_SS_GPIO_Port, SPI1_SS_Pin, GPIO_PIN_SET);

    }
}

void send_test_message() {
    FDCAN_TxHeaderTypeDef txHeader;
    uint8_t txData[8] = {0xDE, 0xAD, 0xBE, 0xEF, 0xCA, 0xFE, 0xBA, 0xBE};

    txHeader.Identifier = 0x123;
    txHeader.IdType = FDCAN_STANDARD_ID;
    txHeader.TxFrameType = FDCAN_DATA_FRAME;
    txHeader.DataLength = FDCAN_DLC_BYTES_8;
    txHeader.ErrorStateIndicator = FDCAN_ESI_ACTIVE;
    txHeader.BitRateSwitch = FDCAN_BRS_OFF;
    txHeader.FDFormat = FDCAN_CLASSIC_CAN;
    txHeader.TxEventFifoControl = FDCAN_NO_TX_EVENTS;
    txHeader.MessageMarker = 0;

    for (int i = 0; i < 10; i++) {
        HAL_FDCAN_AddMessageToTxFifoQ(&hfdcan1, &txHeader, txData);
        HAL_Delay(10); // short delay to separate bursts
    }
}


/* USER CODE END 0 */

/**
  * @brief  The application entry point.
  * @retval int
  */
int main(void)
{
  /* MCU Configuration--------------------------------------------------------*/

  /* Reset of all peripherals, Initializes the Flash interface and the Systick. */
  HAL_Init();

  /* Configure the system clock */
  SystemClock_Config();

  /* Initialize all configured peripherals */
  MX_GPIO_Init();
  MX_DMA_Init();
  MX_ADC1_Init();
  MX_FDCAN1_Init();
  MX_SPI1_Init();
  /* USER CODE BEGIN 2 */
  if (HAL_FDCAN_Start(&hfdcan1) != HAL_OK) {
        Error_Handler();  // Only once here
    }

  HAL_GPIO_WritePin(GPIOD, GPIO_PIN_2, GPIO_PIN_RESET);
  HAL_GPIO_WritePin(GPIOD, GPIO_PIN_3, GPIO_PIN_RESET);
  HAL_GPIO_WritePin(GPIOB, GPIO_PIN_0, GPIO_PIN_RESET);
  HAL_GPIO_WritePin(GPIOB, GPIO_PIN_1, GPIO_PIN_RESET);
  //sleep -> ready
  tx_buffer[0] = OUT_READY;
  tx_buffer[1] = OUT_READY;
  tx_buffer[2] = OUT_READY;
  tx_buffer[3] = OUT_READY;
  tx_buffer[4] = OUT_READY;
  HAL_GPIO_WritePin(SPI1_SS_GPIO_Port, SPI1_SS_Pin, GPIO_PIN_RESET);
  HAL_SPI_TransmitReceive(&hspi1, tx_buffer, rx_buffer, 5, 100);
  HAL_GPIO_WritePin(SPI1_SS_GPIO_Port, SPI1_SS_Pin, GPIO_PIN_SET);
  //ready -> active
  tx_buffer[0] = DCR_ACTIVE;
  tx_buffer[1] = DCR_ACTIVE; 	//fuse 4
  tx_buffer[2] = DCR_ACTIVE;		//fuse 3
  tx_buffer[3] = DCR_ACTIVE;		//fuse 2
  tx_buffer[4] = DCR_ACTIVE;		//fuse 1
  HAL_GPIO_WritePin(SPI1_SS_GPIO_Port, SPI1_SS_Pin, GPIO_PIN_RESET);
  HAL_SPI_TransmitReceive(&hspi1, tx_buffer, rx_buffer, 5, 100);
  HAL_GPIO_WritePin(SPI1_SS_GPIO_Port, SPI1_SS_Pin, GPIO_PIN_SET);


  HAL_ADC_Start_DMA(&hadc1, adc_buffer, ADC_BUF_SIZE);



  HAL_Delay(100);


  /* USER CODE END 2 */

  /* Infinite loop */
  /* USER CODE BEGIN WHILE */
  while (1)
  {

	  //CAN

	  send_test_message();
	  HAL_Delay(1000);

	  // OPTIONAL: Read diagnostic registers to check for critical errors
	  uint8_t tx_buffer_diag[4] = {ERRDIAG, 0, 0, 0};
	  uint8_t rx_buffer_diag[4];

	  HAL_GPIO_WritePin(SPI1_SS_GPIO_Port, SPI1_SS_Pin, GPIO_PIN_RESET);
	  HAL_SPI_TransmitReceive(&hspi1, tx_buffer_diag, rx_buffer_diag, 4, 100);
	  HAL_GPIO_WritePin(SPI1_SS_GPIO_Port, SPI1_SS_Pin, GPIO_PIN_SET);

	  // If all controllers report a major failure, turn all LEDs ON permanently
	  if ((rx_buffer_diag[1] & 0xFF) == 0xFF &&
	      (rx_buffer_diag[2] & 0xFF) == 0xFF &&
	      (rx_buffer_diag[3] & 0xFF) == 0xFF &&
	      (rx_buffer_diag[4] & 0xFF) == 0xFF)
	  {
	      HAL_GPIO_WritePin(LED1_GPIO_Port, LED1_Pin, GPIO_PIN_SET);
	      HAL_GPIO_WritePin(LED2_GPIO_Port, LED2_Pin, GPIO_PIN_SET);
	      HAL_GPIO_WritePin(LED3_GPIO_Port, LED3_Pin, GPIO_PIN_SET);
	      HAL_GPIO_WritePin(LED4_GPIO_Port, LED4_Pin, GPIO_PIN_SET);

	      while (1);  // Stop execution if all controllers fail
	  }

	  // If no failure, continue blinking
	  HAL_GPIO_TogglePin(LED1_GPIO_Port, LED1_Pin);
	  HAL_GPIO_TogglePin(LED2_GPIO_Port, LED2_Pin);
	  HAL_GPIO_TogglePin(LED3_GPIO_Port, LED3_Pin);
	  HAL_GPIO_TogglePin(LED4_GPIO_Port, LED4_Pin);



//current sense mode activation
	  // set channel 0 - 7A // value fuse = 217,4*current + 93
	  tx_buffer[0] = DCR_CHANNEL0;
	  tx_buffer[1] = DCR_CHANNEL0; //closes fuse4
	  tx_buffer[2] = DCR_CHANNEL0;
	  tx_buffer[3] = DCR_CHANNEL0;
	  tx_buffer[4] = DCR_CHANNEL0;
	  HAL_GPIO_WritePin(SPI1_SS_GPIO_Port, SPI1_SS_Pin, GPIO_PIN_RESET);
	  HAL_SPI_TransmitReceive(&hspi1, tx_buffer, rx_buffer, 5, 100);
	  HAL_GPIO_WritePin(SPI1_SS_GPIO_Port, SPI1_SS_Pin, GPIO_PIN_SET);
	  HAL_GPIO_WritePin(SPI1_SS_GPIO_Port, SPI1_SS_Pin, GPIO_PIN_RESET);
	  HAL_SPI_TransmitReceive(&hspi1, tx_buffer, rx_buffer, 5, 100);
	  HAL_GPIO_WritePin(SPI1_SS_GPIO_Port, SPI1_SS_Pin, GPIO_PIN_SET);
	  // check current on channel 0 - 7A
	  fuse_currents[0][0] = __HAL_ADC_CALC_DATA_TO_VOLTAGE(__VREFANALOG_VOLTAGE__, adc_buffer[3], ADC_RESOLUTION12b); // IC0 - CH0
	  fuse_currents[1][0] = __HAL_ADC_CALC_DATA_TO_VOLTAGE(__VREFANALOG_VOLTAGE__, adc_buffer[2], ADC_RESOLUTION12b); // IC1 - CH0
	  fuse_currents[2][0] = __HAL_ADC_CALC_DATA_TO_VOLTAGE(__VREFANALOG_VOLTAGE__, adc_buffer[1], ADC_RESOLUTION12b); // IC2 - CH0
	  fuse_currents[3][0] = __HAL_ADC_CALC_DATA_TO_VOLTAGE(__VREFANALOG_VOLTAGE__, adc_buffer[0], ADC_RESOLUTION12b); // IC3 - CH0
	  // ...repeat for CH1-CH3

	  // set channel 1 - 4A // value fuse = 217,4*current + 93
	  tx_buffer[0] = DCR_CHANNEL1;
	  tx_buffer[1] = DCR_CHANNEL1;
	  tx_buffer[2] = DCR_CHANNEL1;
	  tx_buffer[3] = DCR_CHANNEL1;
	  tx_buffer[4] = DCR_CHANNEL1;
	  HAL_GPIO_WritePin(SPI1_SS_GPIO_Port, SPI1_SS_Pin, GPIO_PIN_RESET);
	  HAL_SPI_TransmitReceive(&hspi1, tx_buffer, rx_buffer, 5, 100);
	  HAL_GPIO_WritePin(SPI1_SS_GPIO_Port, SPI1_SS_Pin, GPIO_PIN_SET);
	  HAL_GPIO_WritePin(SPI1_SS_GPIO_Port, SPI1_SS_Pin, GPIO_PIN_RESET);
	  HAL_SPI_TransmitReceive(&hspi1, tx_buffer, rx_buffer, 5, 100);
	  HAL_GPIO_WritePin(SPI1_SS_GPIO_Port, SPI1_SS_Pin, GPIO_PIN_SET);
	  // check current on channel 1 - 4A
	  fuse_currents[0][1] = __HAL_ADC_CALC_DATA_TO_VOLTAGE(__VREFANALOG_VOLTAGE__, adc_buffer[3], ADC_RESOLUTION12b); // IC0
	  fuse_currents[1][1] = __HAL_ADC_CALC_DATA_TO_VOLTAGE(__VREFANALOG_VOLTAGE__, adc_buffer[2], ADC_RESOLUTION12b); // IC1
	  fuse_currents[2][1] = __HAL_ADC_CALC_DATA_TO_VOLTAGE(__VREFANALOG_VOLTAGE__, adc_buffer[1], ADC_RESOLUTION12b); // IC2
	  fuse_currents[3][1] = __HAL_ADC_CALC_DATA_TO_VOLTAGE(__VREFANALOG_VOLTAGE__, adc_buffer[0], ADC_RESOLUTION12b); // IC3

	  // set channel 2 - 4A // value fuse = 217,4*current + 93
	  tx_buffer[0] = DCR_CHANNEL2;
	  tx_buffer[1] = DCR_CHANNEL2;
	  tx_buffer[2] = DCR_CHANNEL2;
	  tx_buffer[3] = DCR_CHANNEL2;
	  tx_buffer[4] = DCR_CHANNEL2;
	  HAL_GPIO_WritePin(SPI1_SS_GPIO_Port, SPI1_SS_Pin, GPIO_PIN_RESET);
	  HAL_SPI_TransmitReceive(&hspi1, tx_buffer, rx_buffer, 5, 100);
	  HAL_GPIO_WritePin(SPI1_SS_GPIO_Port, SPI1_SS_Pin, GPIO_PIN_SET);
	  HAL_GPIO_WritePin(SPI1_SS_GPIO_Port, SPI1_SS_Pin, GPIO_PIN_RESET);
	  HAL_SPI_TransmitReceive(&hspi1, tx_buffer, rx_buffer, 5, 100);
	  HAL_GPIO_WritePin(SPI1_SS_GPIO_Port, SPI1_SS_Pin, GPIO_PIN_SET);
	  // check current on channel 2 - 4A
	  fuse_currents[0][2] = __HAL_ADC_CALC_DATA_TO_VOLTAGE(__VREFANALOG_VOLTAGE__, adc_buffer[3], ADC_RESOLUTION12b); // IC0
	  fuse_currents[1][2] = __HAL_ADC_CALC_DATA_TO_VOLTAGE(__VREFANALOG_VOLTAGE__, adc_buffer[2], ADC_RESOLUTION12b); // IC1
	  fuse_currents[2][2] = __HAL_ADC_CALC_DATA_TO_VOLTAGE(__VREFANALOG_VOLTAGE__, adc_buffer[1], ADC_RESOLUTION12b); // IC2
	  fuse_currents[3][2] = __HAL_ADC_CALC_DATA_TO_VOLTAGE(__VREFANALOG_VOLTAGE__, adc_buffer[0], ADC_RESOLUTION12b); // IC3


	  // set channel 3 - 7A // value fuse = 217,4*current + 93
	  tx_buffer[0] = DCR_CHANNEL3;
	  tx_buffer[1] = DCR_CHANNEL3;
	  tx_buffer[2] = DCR_CHANNEL3;
	  tx_buffer[3] = DCR_CHANNEL3;
	  tx_buffer[4] = DCR_CHANNEL3;
	  HAL_GPIO_WritePin(SPI1_SS_GPIO_Port, SPI1_SS_Pin, GPIO_PIN_RESET);
	  HAL_SPI_TransmitReceive(&hspi1, tx_buffer, rx_buffer, 5, 100);
	  HAL_GPIO_WritePin(SPI1_SS_GPIO_Port, SPI1_SS_Pin, GPIO_PIN_SET);
	  HAL_GPIO_WritePin(SPI1_SS_GPIO_Port, SPI1_SS_Pin, GPIO_PIN_RESET);
	  HAL_SPI_TransmitReceive(&hspi1, tx_buffer, rx_buffer, 5, 100);
	  HAL_GPIO_WritePin(SPI1_SS_GPIO_Port, SPI1_SS_Pin, GPIO_PIN_SET);
	  // check current on channel 3 - 7A // value fuse = 217,4*current + 93
	  fuse_currents[0][3] = __HAL_ADC_CALC_DATA_TO_VOLTAGE(__VREFANALOG_VOLTAGE__, adc_buffer[3], ADC_RESOLUTION12b); // IC0
	  fuse_currents[1][3] = __HAL_ADC_CALC_DATA_TO_VOLTAGE(__VREFANALOG_VOLTAGE__, adc_buffer[2], ADC_RESOLUTION12b); // IC1
	  fuse_currents[2][3] = __HAL_ADC_CALC_DATA_TO_VOLTAGE(__VREFANALOG_VOLTAGE__, adc_buffer[1], ADC_RESOLUTION12b); // IC2
	  fuse_currents[3][3] = __HAL_ADC_CALC_DATA_TO_VOLTAGE(__VREFANALOG_VOLTAGE__, adc_buffer[0], ADC_RESOLUTION12b); // IC3
	  //activating each channel individually by calling a function



	  HAL_Delay(100);

	  tx_buffer[0] = OUT_READ;
	  tx_buffer[1] = OUT_READ;
	  tx_buffer[2] = OUT_READ;
	  tx_buffer[3] = OUT_READ;
	  tx_buffer[4] = OUT_READ;
	  HAL_GPIO_WritePin(SPI1_SS_GPIO_Port, SPI1_SS_Pin, GPIO_PIN_RESET);
	  HAL_SPI_TransmitReceive(&hspi1, tx_buffer, rx_buffer, 5, 100);
	  HAL_GPIO_WritePin(SPI1_SS_GPIO_Port, SPI1_SS_Pin, GPIO_PIN_SET);
	  HAL_GPIO_WritePin(SPI1_SS_GPIO_Port, SPI1_SS_Pin, GPIO_PIN_RESET);
	  HAL_SPI_TransmitReceive(&hspi1, tx_buffer, rx_buffer, 5, 100);
	  HAL_GPIO_WritePin(SPI1_SS_GPIO_Port, SPI1_SS_Pin, GPIO_PIN_SET);



	  for (uint8_t ic = 0; ic < IC_COUNT; ic++) {
	      for (uint8_t ch = 0; ch < CHANNEL_COUNT; ch++) {
	          handle_overcurrent(ic, ch, thresholds[ic][ch]);
	      }
	  }

	  if (any_channel_closed && (HAL_GetTick() - last_shutdown_time >= 5000))
	  {
	      any_channel_closed = false; // reset the flag

	      for (uint8_t ic = 0; ic < IC_COUNT; ic++)
	      {
	          uint8_t adc_index = 3 - ic;
	          for (uint8_t ch = 0; ch < CHANNEL_COUNT; ch++)
	          {
	              fuse_currents[ic][ch] = __HAL_ADC_CALC_DATA_TO_VOLTAGE(
	                  __VREFANALOG_VOLTAGE__, adc_buffer[adc_index], ADC_RESOLUTION12b);

	              if (fuse_currents[ic][ch] <= thresholds[ic][ch])
	              {
	                  channel_states[ic] |= (1 << ch); // enable channel
	              }
	          }

	          // Send updated state
	          uint8_t tx_index = get_tx_index(ic);
	          for (int i = 0; i < 5; i++) tx_buffer[i] = DCR_ACTIVE;
	          tx_buffer[tx_index] = 0x80 | (channel_states[ic] & 0x0F);

	          HAL_GPIO_WritePin(SPI1_SS_GPIO_Port, SPI1_SS_Pin, GPIO_PIN_RESET);
	          HAL_SPI_TransmitReceive(&hspi1, tx_buffer, rx_buffer, 5, 100);
	          HAL_GPIO_WritePin(SPI1_SS_GPIO_Port, SPI1_SS_Pin, GPIO_PIN_SET);
	      }
	  }


	 	  after_first_loop = 1;

    /* USER CODE END WHILE */

    /* USER CODE BEGIN 3 */
  }
  /* USER CODE END 3 */
}

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
/**
  * @brief  Period elapsed callback in non blocking mode
  * @note   This function is called  when TIM1 interrupt took place, inside
  * HAL_TIM_IRQHandler(). It makes a direct call to HAL_IncTick() to increment
  * a global variable "uwTick" used as application time base.
  * @param  htim : TIM handle
  * @retval None
  */
void HAL_TIM_PeriodElapsedCallback(TIM_HandleTypeDef *htim)
{
  if (htim->Instance == TIM1) {
    HAL_IncTick();
  }
}

/**
  * @brief  This function is executed in case of error occurrence.
  * @retval None
  */
void Error_Handler(void)
{
  /* USER CODE BEGIN Error_Handler_Debug */
  /* User can add his own implementation to report the HAL error return state */
  __disable_irq();
  while (1)
  {
  }
  /* USER CODE END Error_Handler_Debug */
}

#ifdef  USE_FULL_ASSERT
/**
  * @brief  Reports the name of the source file and the source line number
  *         where the assert_param error has occurred.
  * @param  file: pointer to the source file name
  * @param  line: assert_param error line source number
  * @retval None
  */
void assert_failed(uint8_t *file, uint32_t line)
{
  /* USER CODE BEGIN 6 */
  /* User can add his own implementation to report the file name and line number,
     ex: printf("Wrong parameters value: file %s on line %d\r\n", file, line) */
  /* USER CODE END 6 */
}
#endif /* USE_FULL_ASSERT */
