PUT-Motorsport/PUTM_EV_PDMv2_2024/Software/firmware/PUTM_EV_PDM_2024.ioc

Mcu.UserName=STM32G0C1KCTxN
PA0.GPIO_Label=FUSE1
PA0.Signal=ADC1_IN0
PA1.GPIO_Label=FUSE2
PA1.Signal=ADC1_IN1
PA10.GPIO_Label=LED1
PA10.Signal=GPIO_Output
PA13.Signal=SYS_SWDIO
PA14-BOOT0.Signal=SYS_SWCLK
PA2.GPIO_Label=FUSE3
PA2.Signal=ADC1_IN2
PA3.GPIO_Label=FUSE4
PA3.Signal=ADC1_IN3
PA4.GPIO_Label=SPI1_SS
PA4.Signal=GPIO_Output
PA5.Signal=SPI1_SCK
PA6.Signal=SPI1_MISO
PA7.Signal=SPI1_MOSI
PA8.GPIO_Label=LED3
PA8.Signal=GPIO_Output
PA9.GPIO_Label=LED2
PA9.Signal=GPIO_Output
PB0.GPIO_Label=LHI_3
PB0.Signal=GPIO_Output
PB1.GPIO_Label=LHI_4
PB1.Signal=GPIO_Output
PB15.GPIO_Label=LED4
PB15.Signal=GPIO_Output
PB6.Signal=USART1_TX
PB7.Signal=USART1_RX
PD0.Signal=FDCAN1_RX
PD1.Signal=FDCAN1_TX
PD2.GPIO_Label=LHI_1
PD2.Signal=GPIO_Output
PD3.GPIO_Label=LHI_2
PD3.Signal=GPIO_Output
