PUT-Motorsport/PUTM_EV_PDMv2_2024/Software/firmware/Core/Inc/tasksPrototypes.h

/*
 * tasks.h
 *
 *  Created on: Feb 22, 2024
 *      Author: lenovo
 */

#ifndef INC_TASKSPROTOTYPES_H_
#define INC_TASKSPROTOTYPES_H_

#ifdef __cplusplus
extern "C"
{
#endif //__cplusplus

void mainTaskEntry(void* argument);
void canTaskEntry(void* argument);

#ifdef __cplusplus
}
#endif //__cplusplus

#endif /* INC_TASKSPROTOTYPES_H_ */
