PUT-Motorsport/PUTM_EV_PDMv2_2024/(commit log)

2024-11-05 New project, started scheme
    [CAN.kicad_sch, Controllers.kicad_sch, IC.kicad_sch, LEDs.kicad_sch, PUTM_EV_PDMv2_2024.kicad_pcb, PUTM_EV_PDMv2_2024.kicad_sch, Power.kicad_sch, UPT-02-01-01-L-RA.stp]
2024-11-11 Finished schematic
    Added UCB C connection
    Added CAN
    Power ICs schematic fixed
    [7447786147.stp, CAN.kicad_sch, FTSH-107-01-L-DV-K-A.stp]
2024-11-14 Minor fixes
    [CAN.kicad_sch, Controllers.kicad_sch, IC.kicad_sch, PUTM_EV_PDMv2_2024.kicad_sch, Power.kicad_sch, connectors.kicad_sch]
2024-11-20 Footprint changes + started PCB
    [BTS722204ESAXUMA1.stp, CAN.kicad_sch, IC.kicad_sch, LEDs.kicad_sch, PUTM_EV_PDMv2_2024.kicad_pcb, PUTM_EV_PDMv2_2024.kicad_sch, Power.kicad_sch, connectors.kicad_sch]
2024-11-26 Minor changes
    [CAN.kicad_sch, PUTM_EV_PDMv2_2024.csv, PUTM_EV_PDMv2_2024.kicad_sch, Power.kicad_sch, connectors.kicad_sch]
2024-12-08 Layout done
    Added layout
    [7464100.stp, 74650073R.stp, PUTM_EV_PDMv2_2024.kicad_pcb, PUTM_EV_PDMv2_2024.kicad_sch, Power.kicad_sch, SKL34.stp, UMPT-08-01-L-RA-WT-P-TR--3DModel-STEP-418109.STEP, UMPT-08-01-L-RA-WT-P-TR.step]
2024-12-09 Minor changes
    Added battery zone on the f.cu
    Easier connector soldering (additional pads)
    Changed 3.3V layer
    [IC.kicad_sch, PUTM_EV_PDMv2_2024.kicad_pcb]
2024-12-13 Minor fixes
    added USBc tvs
    [IC.kicad_sch, PUTM_EV_PDMv2_2024.kicad_pcb, PUTM_EV_PDMv2_2024.kicad_sch, bom.csv, designators.csv, positions.csv]
2025-03-18 last unchecked harware update - fix dir structure
    [7447786147.stp, 7464100.stp, 74650073R.stp, BTS722204ESAXUMA1.stp, CAN.kicad_sch, Controllers.kicad_sch, FTSH-107-01-L-DV-K-A.stp, IC.kicad_sch]
2025-03-18 soft branch create
    [PUTM_EV_PDM_2024 Debug.cfg]
2025-03-29 Single channel closing
    Added functionality of closing one channel when detecting overcurrent and opening, when the overcurrent is no longer detected
    [main.c]
