PUT-Motorsport/PUTM_EV_PDMv2_2024/(notices)

Notices in the files:
Software/firmware/Core/Inc/main.h:
Copyright (c) 2024 STMicroelectronics.
All rights reserved.
This software is licensed under terms that can be found in the LICENSE file
hardware/hardware/UPT-02-01-01-L-RA/UPT-02-01-01-L-RA.stp:
author */ ('License CC BY-ND 4.0'),
